wagiminator/ATtiny85-IR2USB/documentation/IR2USB_pic2.jpg

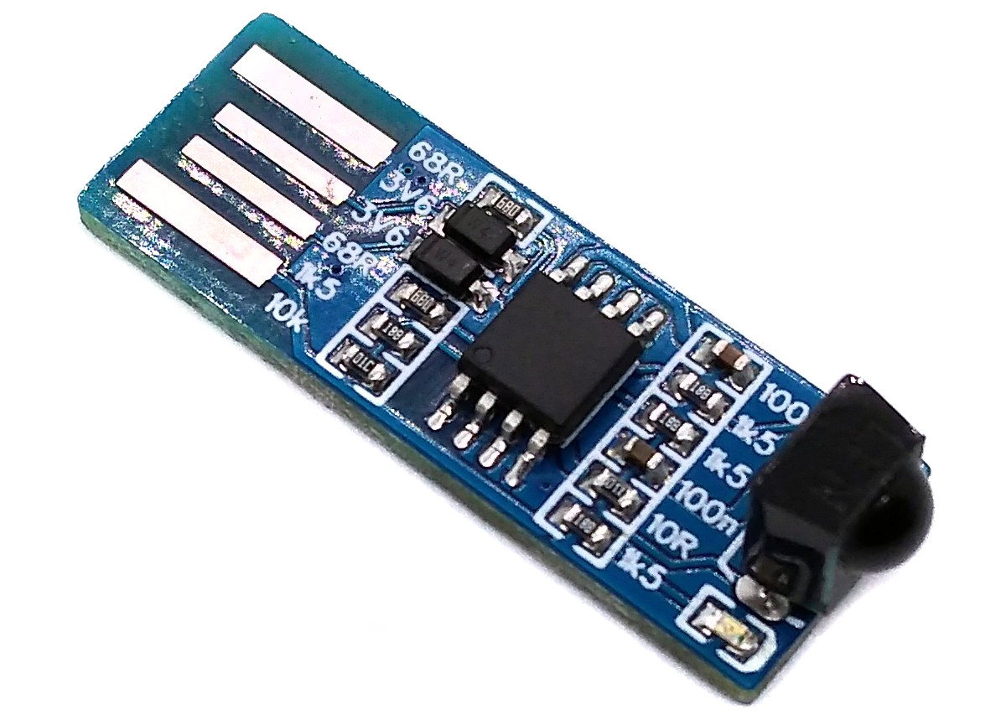
documentation/IR2USB_pic2.jpg
