wagiminator/ATtiny85-IR2USB/hardware/IR2USB_BOM.tsv

ID | Name | Designator | Footprint | Quantity | Manufacturer Part | Manufacturer | Supplier | Supplier Part | Price
1 | USB | USB1 | USB-M-48-2 | 1 | USB-05 | SOFNG | LCSC | C112454 | 0.086
2 | 10k | R1 | 0603 | 1 | 0603WAF1002T5E | UniOhm | LCSC | C25804 | 0.001
3 | 68R | R2,R3 | 0603 | 2 | 0603WAF680JT5E | UniOhm | LCSC | C27592 | 0.001
4 | 1k5 | R4,R6,R7,R8 | 0603 | 4 | 0603WAF1501T5E | UniOhm | LCSC | C22843 | 0.001
5 | 10R | R5 | 0603 | 1 | 0603WAF100JT5E | UniOhm | LCSC | C22859 | 0.001
6 | 100n | C1,C3 | C_0603 | 2 | CC0603KRX7R9BB104 | YAGEO | LCSC | C14663 | 0.002
7 | PWR | LED1 | LED0603 | 1 | 19-217/GHC-YR1S2/3T | EVERLIGHT | LCSC | C72043 | 0.027
8 | RCV | LED2 | LED0603 | 1 | KT-0603R | KENTO | LCSC | C2286
9 | ATtiny85 | U1 | SOIC-8_208MIL | 1 | ATTINY85-20SU | MICROCHIP | LCSC | C89852 | 4.607
10 | TSOP4838 | U3 | TSOP18XX | 1 | TSOP4838 | VISHAY | LCSC | C124647 | 0.774
11 | 3V6 | D1,D2 | ZENER-SOD-123 | 2 | BZT52C3V6 | (MDD) Jiangsu Yutai Elec | LCSC | C173412 | 0.016
