wagiminator/ATtiny85-IR2USB/hardware/IR2USB_schematic.pdf

# VCCPB⁵

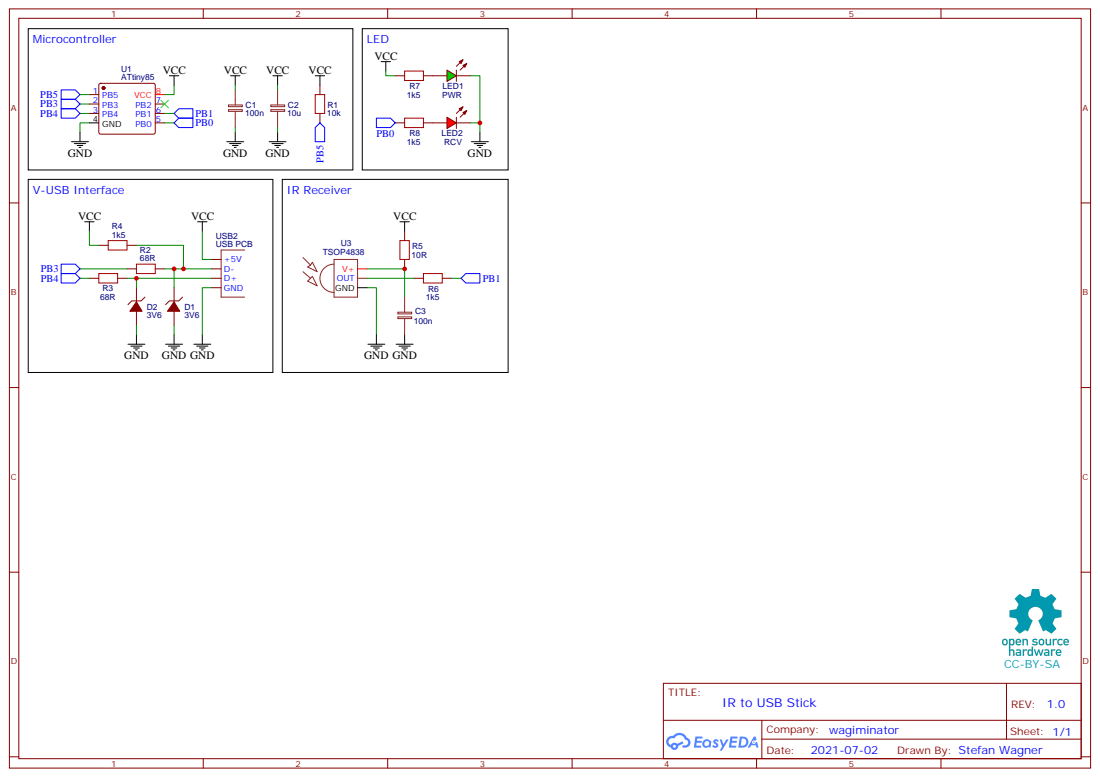
[picture p5: page 1]

Drawn By: Stefan Wagner
